trocolis/epromnator/hardware/gravador-eeprom.pdf

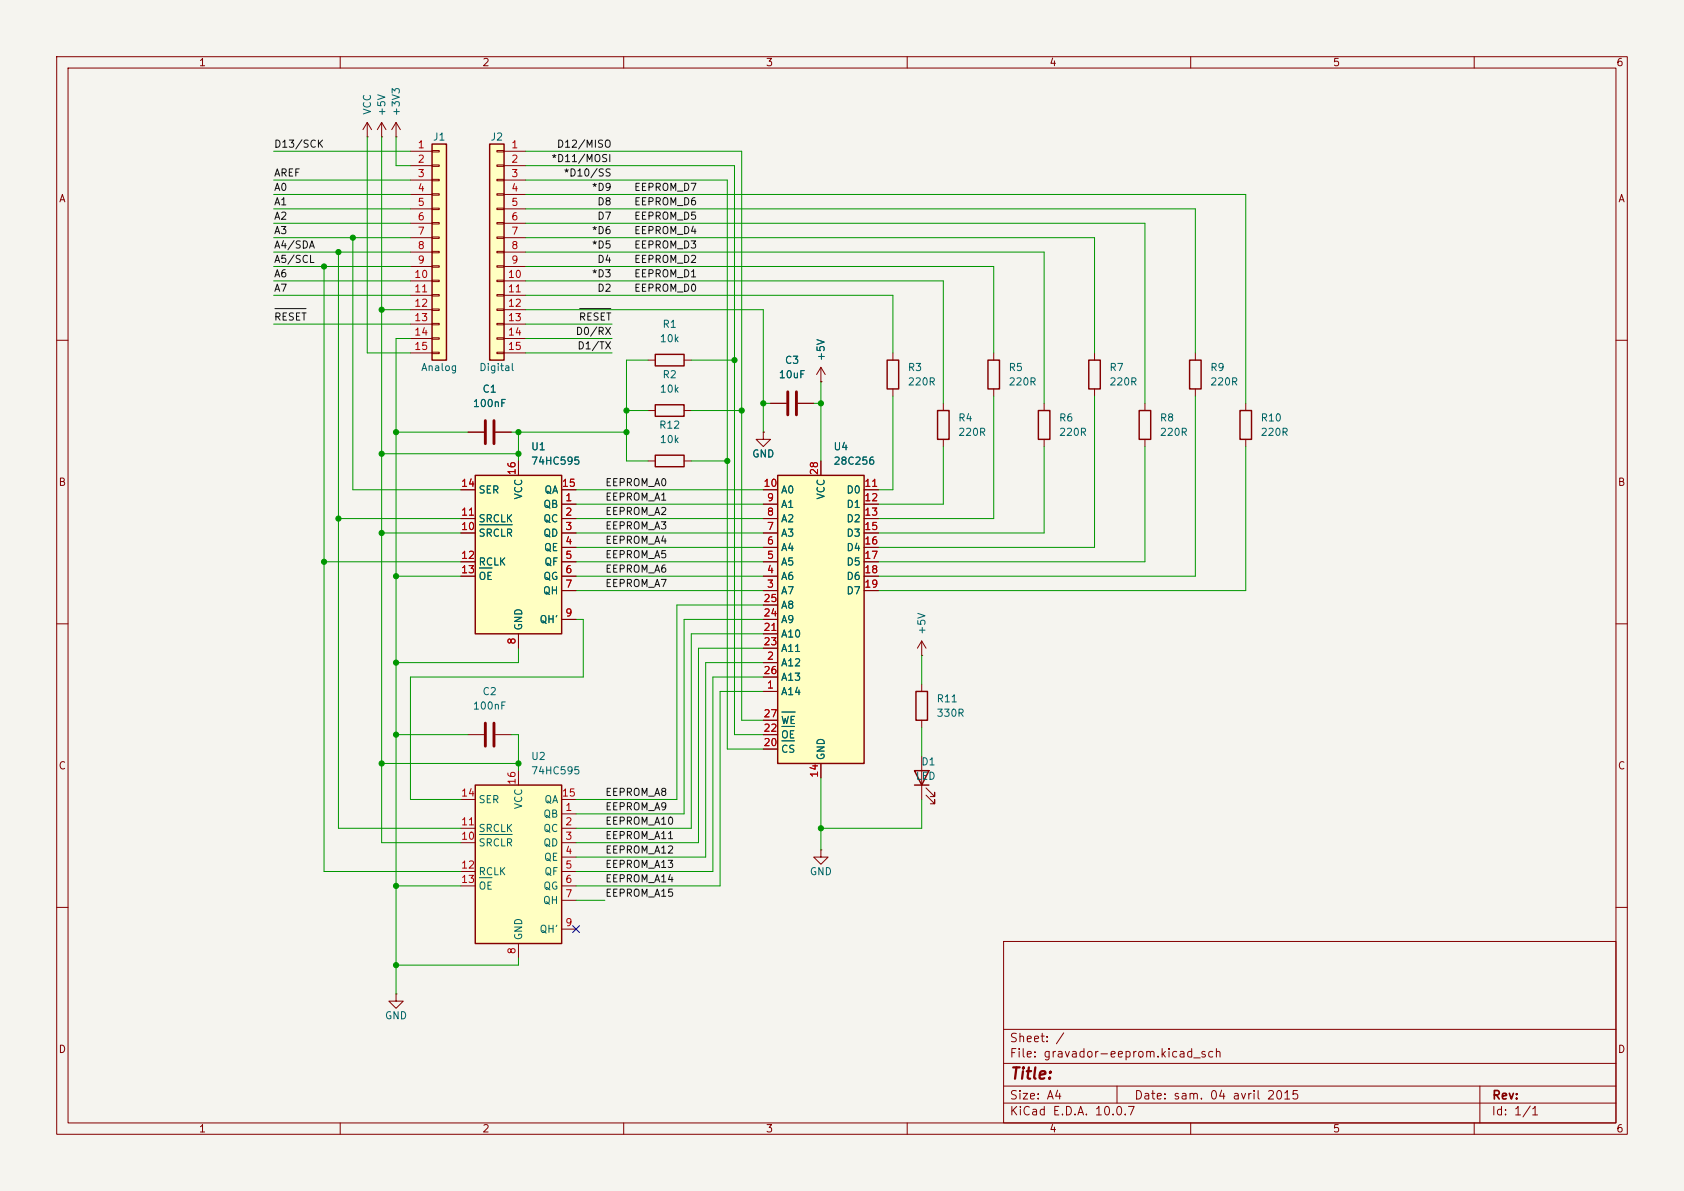
[picture p1: page 1]

*D9D7 D0/RX EEPROM_D4

*D5 EEPROM_D3

*D3D2 RESET D4 10

EEPROM_D2

11 EEPROM_D0
12

SRCLR 10 SRCLK 11 RCLK 12 OE 13

EEPROM_A5 | A5 5
EEPROM_A6 | A6 4

Size: A4 | Rev:
KiCad E.D.A. 10.0.7 | Id: 1/1
