trocolis/epromnator/hardware/gravador-eeprom.kicad_sch

## KiCad design hardware/gravador-eeprom.kicad_sch (2026-10-16)

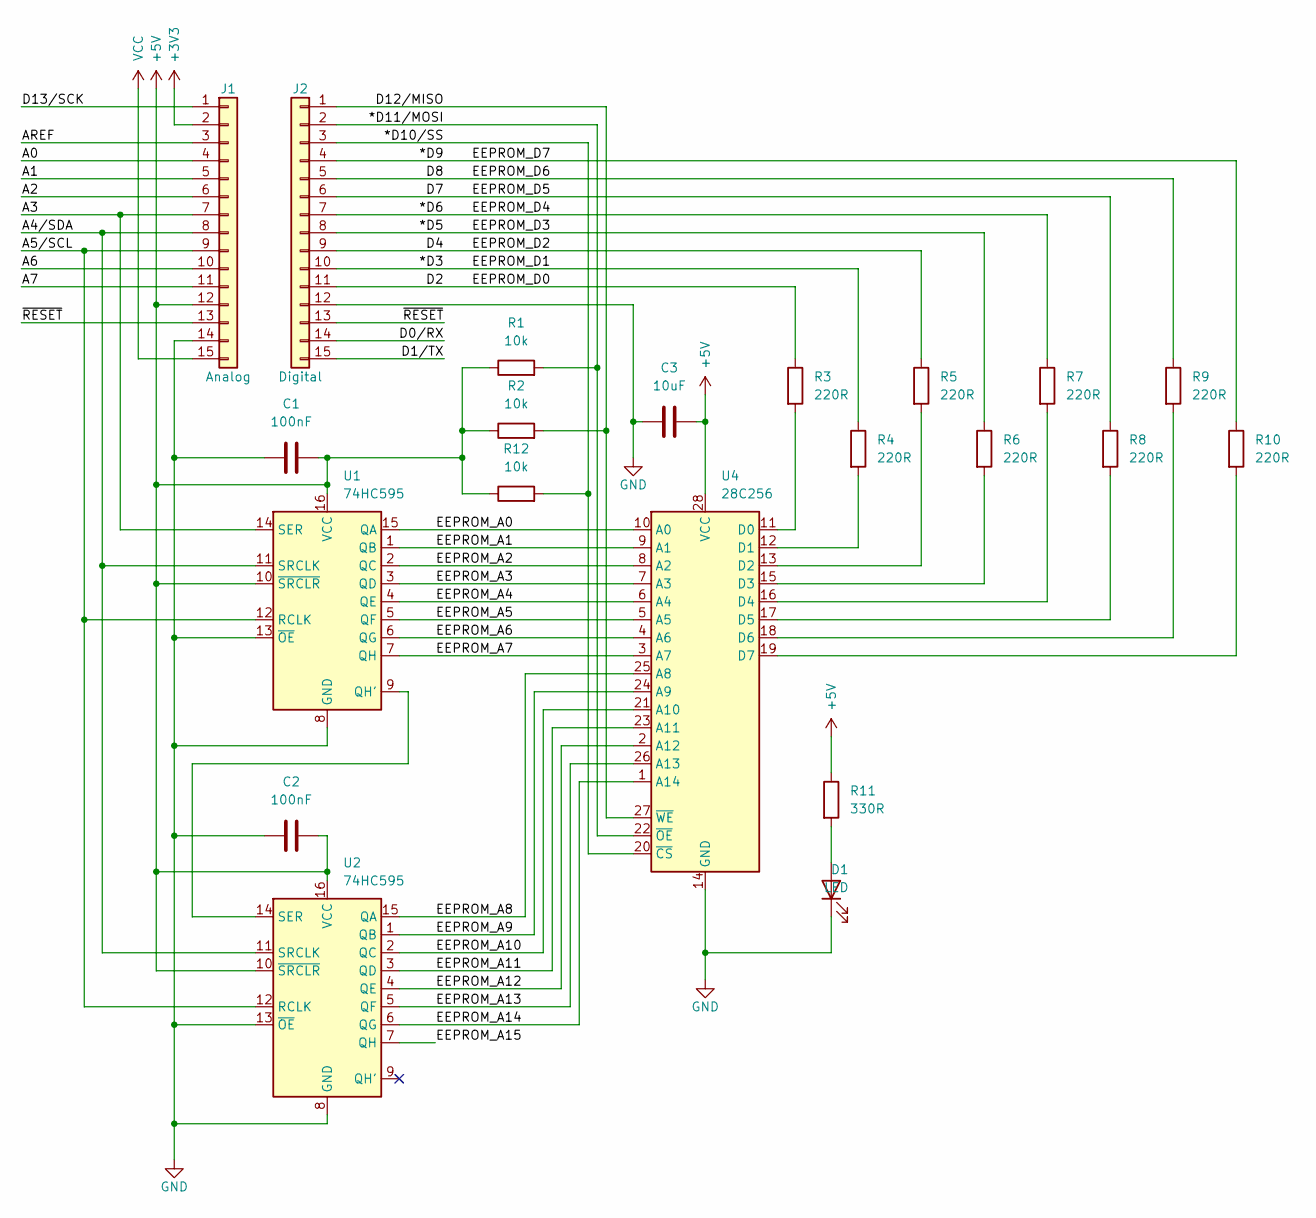
[picture p2: schematic gravador-eeprom.kicad_sch]

Parts:
C1, C2: 100nF
C3: 10uF
D1: LED
J1: Analog; PinHeader_1x15_P2.54mm_Vertical
J2: Digital; PinHeader_1x15_P2.54mm_Vertical
R1, R2, R12: 10k
R3, R4, R5, R6, R7, R8, R9, R10: 220R
R11: 330R
U1, U2: 74HC595
U4: 28C256

Connections:
+3V3: J1.2
+5V: C1.2, C2.2, C3.1, J1.12, R1.1, R2.1, R11.1, R12.1, U1.10 (~SRCLR), U1.16 (VCC), U2.10 (~SRCLR), U2.16 (VCC), U4.28 (VCC)
A0: J1.4
A1: J1.5
A2: J1.6
A3: J1.7, U1.14 (SER)
A4/SDA: J1.8, U1.11 (SRCLK), U2.11 (SRCLK)
A5/SCL: J1.9, U1.12 (RCLK), U2.12 (RCLK)
A6: J1.10
A7: J1.11
AREF: J1.3
D0/RX: J2.14
D1/TX: J2.15
D2: J2.11, R3.1
D4: J2.9, R5.1
D7: J2.6, R8.1
D8: J2.5, R9.1
D12/MISO: J2.1, R2.2, U4.27 (~WE)
D13/SCK: J1.1
EEPROM_A0: U1.15 (QA), U4.10 (A0)
EEPROM_A1: U1.1 (QB), U4.9 (A1)
EEPROM_A2: U1.2 (QC), U4.8 (A2)
EEPROM_A3: U1.3 (QD), U4.7 (A3)
EEPROM_A4: U1.4 (QE), U4.6 (A4)
EEPROM_A5: U1.5 (QF), U4.5 (A5)
EEPROM_A6: U1.6 (QG), U4.4 (A6)
EEPROM_A7: U1.7 (QH), U4.3 (A7)
EEPROM_A8: U2.15 (QA), U4.25 (A8)
EEPROM_A9: U2.1 (QB), U4.24 (A9)
EEPROM_A10: U2.2 (QC), U4.21 (A10)
EEPROM_A11: U2.3 (QD), U4.23 (A11)
EEPROM_A12: U2.4 (QE), U4.2 (A12)
EEPROM_A13: U2.5 (QF), U4.26 (A13)
EEPROM_A14: U2.6 (QG), U4.1 (A14)
EEPROM_A15: U2.7 (QH)
GND: C1.1, C2.1, C3.2, D1.1 (K), J1.14, J2.12, U1.8 (GND), U1.13 (~OE), U2.8 (GND), U2.13 (~OE), U4.14 (GND)
unnamed: D1.2 (A), R11.2
unnamed: R3.2, U4.11 (D0)
unnamed: R4.2, U4.12 (D1)
unnamed: R5.2, U4.13 (D2)
unnamed: R6.2, U4.15 (D3)
unnamed: R7.2, U4.16 (D4)
unnamed: R8.2, U4.17 (D5)
unnamed: R9.2, U4.18 (D6)
unnamed: R10.2, U4.19 (D7)
unnamed: U1.9 (QH'), U2.14 (SER)
VCC: J1.15
d3: J2.10, R4.1
d5: J2.8, R6.1
d6: J2.7, R7.1
d9: J2.4, R10.1
d10/ss: J2.3, R12.2, U4.20 (~CS)
d11/mosi: J2.2, R1.2, U4.22 (~OE)
~RESET: J1.13, J2.13
