trocolis/epromnator/firmware/src/Version.h

// =============================================================================
//  Version.h — versão do firmware (informada em GET_INFO/HELLO)
// =============================================================================
#pragma once

#define FW_VERSION_MAJOR 1
#define FW_VERSION_MINOR 1
#define FW_VERSION_PATCH 0
