trocolis/epromnator/(commit log)

2026-10-16 Etapa 0: estrutura do repositório e plano de implementação
    Move os arquivos do KiCad para hardware/, adiciona .gitignore, README
    e docs/PLANO.md com mapa de pinos, etapas e decisões.
    [gravador-eeprom.kicad_sch]
2026-10-16 Etapa 1: correções no esquema do hardware
    - D1 (LED de alimentação) estava invertido: anodo no GND e catodo via
    R11 ao +5V, nunca acenderia. Símbolo girado 180°.
    - C3 sem valor definido: agora 10uF (capacitor de reserva do soquete).
    - PDF do esquema regenerado.
    [gravador-eeprom.kicad_sch]
2026-10-16 Etapa 2: HAL do firmware e shell de depuração
    - lib/bus: acesso direto a PORTx/DDRx/PINx para endereços (2x 74HC595,
    MSB primeiro), barramento de dados (PD2..PD7 + PB0..PB1) e controles
    ~CE/~OE/~WE; LED de ocupado em D13.
    - src/DebugShell: comandos de texto para conferir a placa com
    multímetro (a, d, z) e ler/gravar bytes (r, w).
2026-10-16 Etapa 3: driver 28Cxxx (página, data polling, SDP)
    - lib/eeprom28c: leitura de byte/bloco, escrita em modo página ou byte
    com cargas sem interrupções (tBLC <= 150 us), fim de ciclo por data
    polling (D7) com timeout e verificação por releitura.
    - SDP: habilitar, desabilitar e escrita protegida opcional.
    - Apagamento pulando páginas vazias, verificação de vazio e CRC32.
    - Shell de depuração passa a usar o driver e ganha os comandos
    b, c, e, s e o autoteste destrutivo 't !'.
2026-10-16 Etapa 4: protocolo binário, framing e testes nativos
    - protocol/epromnator_protocol.h: quadros com SOF, SEQ, LEN e
    CRC-16/CCITT; comandos PING, GET_INFO, CONFIG, READ, WRITE,
    BLANK_CHECK, CRC32, ERASE e SDP; HELLO espontâneo no boot.
    - lib/framing: FrameParser (máquina de estados com timeout de
    ressincronização) e ResponseWriter (CRC calculado em voo), ambos
    independentes do Arduino.
    - src/CommandHandler: despacho dos comandos para o driver; LED de
    ocupado durante a execução.
    - Ambientes nano_debug (shell de texto) e native (11 testes Unity).
    - tools/fw_smoke_test.py: teste do firmware via pyserial.
2026-10-16 Firmware: endereços SDP mascarados pelo tamanho do chip
    No 28C64 o pino 1 é RDY/~BUSY e está ligado à linha A14 do 595; usar
    0x5555 causaria conflito elétrico. Agora as sequências usam 1555/0AAA
    em chips de 8 KB e o endereço volta a 0 durante a espera do SDP.
2026-10-16 Etapa 5: biblioteca core C++20, emulador e testes
    - SerialPort próprio (termios/poll no Linux e macOS, Win32 no Windows),
    sem dependência do QtSerialPort; listagem de portas USB-serial.
    - ProtocolClient: quadros com SEQ e CRC, descarte de lixo e respostas
    atrasadas, retransmissão em timeout/CRC, erros como exceções.
    - EmulatorTransport: firmware + EEPROM simulados usando o mesmo
    FrameParser do firmware; simula página, SDP e falhas de enlace.
    - Programmer: ler, gravar (pulando páginas 0xFF), verificar por CRC
    de bloco, apagar, verificar vazio, SDP e AUTO, com progresso,
    log e cancelamento.
    - FileFormats: binário, Intel HEX e S-Record (leitura e escrita).
    - Banco de dispositi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
2026-10-16 Etapa 6: ferramenta de linha de comando epromnator-cli
    Operações read, write, verify, erase, blank, auto, sdp-on/off, info,
    checksum, list-devices e list-ports; porta 'emu' usa o emulador.
    Detecção automática de porta única, formatos por extensão, offset e
    faixa de endereços, barra de progresso, cancelamento por Ctrl+C e
    códigos de saída distintos para erro, falha de verificação e uso.
2026-10-16 Etapa 7: interface gráfica Qt 6
    - Janela no padrão dos gravadores comerciais: menus, barra com
    Ler/Gravar/Verificar/Apagar/Vazio/AUTO (F5..F9), seleção de porta
    (inclui emulador), painel do dispositivo, buffer, opções e faixa.
    - HexView próprio: edição hex/ASCII, seleção, destaque de bytes
    alterados, diferenças da verificação em vermelho e 0xFF atenuado.
    - DeviceDialog com busca por nome/fabricante.
    - ProgrammerWorker: Programmer em QThread, progresso, cancelamento
    (Esc) e conexão automática ao iniciar uma operação.
    - Abrir/salvar bin/HEX/S-Record, arquivos recentes, arrastar e
    soltar, oferta de deslocamento para HEX acima da capacidade do
    chip (ex.: ROM de 6502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
2026-10-16 Firmware: correções do teste com a placa real
    O primeiro teste em hardware mostrou que as linhas de dados da montagem
    levam microssegundos para assentar (D4/D5 as piores; provável resistor
    série de valor errado em R3..R10):
    - leitura devolvia o dado do endereço anterior (capacitância da linha);
    - escrita travava bits errados na borda de subida de ~WE.
    - Bus: SETTLE_CYCLES (15 us) antes de ler e antes do pulso de ~WE;
    varredura mostrou falhas com 1 us e 3 us e leitura perfeita com 10 us.
    - Shell de depuração: comando 'v' mede o VCC pelo bandgap (repouso e
    durante um ciclo de gravação).
    - Ambiente nano_old_debug para clones com bootloader antigo.
    - README/PLANO: alerta sobre R3.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
2026-10-16 Firmware: assentamento do barramento reduzido para 1 µs
    Com os resistores série R3–R10 corrigidos para 220 Ω, a varredura na
    placa real (chip inteiro com 00/FF, 55/AA e dados aleatórios, lidos duas
    vezes) passou sem erros de 125 ns a 1 µs; com 62,5 ns a conferência da
    escrita falha. SETTLE_CYCLES passa de 240 (15 µs) para 16 (1 µs) e pode
    ser sobrescrito com -DEPN_SETTLE_CYCLES para repetir a varredura.
2026-10-16 CI: Qt 6.9.3 para corrigir o link no macOS
    O Qt 6.8.3 liga o framework AGL, removido do SDK atual do macOS
    (ld: framework 'AGL' not found). A partir do 6.9.2 o FindWrapOpenGL
    não o usa mais.
2026-10-16 Suporte a SRAM 62256, EEPROMs de 64 KB e identificação do chip
    - Banco de dispositivos com tipo (EEPROM/SRAM): 62256 (SRAM) sem SDP,
    X28C512, CAT28C512 e 28C512 genérico (32 pinos, com adaptador de A15).
    - Firmware 1.1.0: comando IDENTIFY. Grava e restaura até 6 bytes e
    distingue SRAM (escrita imediata), EEPROM (ciclo de gravação), EEPROM
    com SDP ativo, chip somente leitura e soquete vazio; mede o tamanho
    por espelhamento em 0x2000 e 0x8000, sem levar A14 a nível alto.
    Comando "i" no shell de depuração.
    - Software 1.1.0: operação identify na CLI e "Identificar chip"
    (Ctrl+I) na GUI, com sugestão da entrada do banco; tipo do chip na
    lista e no painel. A CLI mostra "C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
